BatoSEC25-ECN/girouette/pcb/orders/pcb_test.ods

Component | Vendor | Quantity | Price (unit) | Price (no TVA) | Price (TVA) | Comment | Vendor link
MAX3221EIPWR | Farnell | 4 | 1.37 € | 5.48 € | 6.58 € | NA | https://fr.farnell.com/texas-instruments/max3221eipwr/rs232-transceiver-250kbps-tssop/dp/3006965
LM555CMX/NOPB | Farnell | 4 | 1.23 € | 4.92 € | 5.90 € | NA | https://fr.farnell.com/texas-instruments/lm555cmx-nopb/ic-timer-8soic/dp/3006901
PTV09A-4020F-B104 | Farnell | 8 | 1.00 € | 8.00 € | 9.60 € | NA | https://fr.farnell.com/bourns/ptv09a-4020f-b104/potentiometre-rotatif-100kohm/dp/2469525
LM324AN | Farnell | 4 | 0.82 € | 3.28 € | 3.94 € | NA | https://fr.farnell.com/texas-instruments/lm324an/ic-op-amp-quad-12mhz/dp/3117049
MCUST16A40S12RO | Farnell | 4 | 3.10 € | 12.40 € | 14.88 € | NA | https://fr.farnell.com/multicomp-pro/mcust16a40s12ro/transmitter-40khz-16mm-metal/dp/2362669
MCUSR16A39S12RO | Farnell | 4 | 3.10 € | 12.40 € | 14.88 € | NA | https://fr.farnell.com/multicomp-pro/mcusr16a39s12ro/receiver-39khz-16mm-metal/dp/2362670
XIAO ESP32C3 | Farnell | 4 | 4.75 € | 19.00 € | 22.80 € | Already possessed ? | https://fr.farnell.com/seeed-studio/113991054/carte-developpement-risc-carte/dp/4060379
Resistors |  |  |  |  |  | Already possessed
Capacitors |  |  |  |  |  | Already possessed
Single row 2.54 headers |  |  |  |  |  | Already possessed ?
 |  |  |  | Total price (no TVA) | Total price (TVA)
 |  |  |  | 65.48 € | 93.58 €
 |  |  |  | Delivery and Manipulation fees
 |  |  |  | 15.00 €
