BatoSEC25-ECN/girouette/modeling/pcb_test/3mf/case.3mf

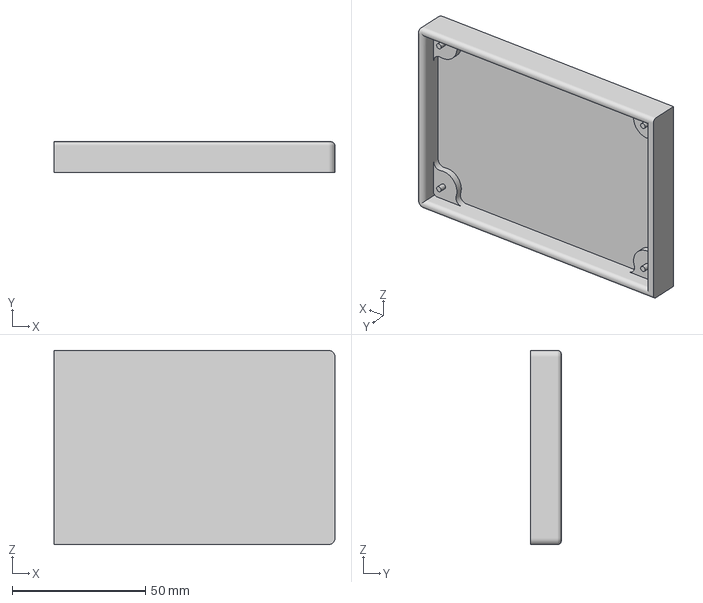
[picture p4: CAD file, 2025-03-26]
modeling/pcb_test/3mf/case.3mf
105.5 x 11.5 x 73.0 mm
