BatoSEC25-ECN/girouette/modeling/pcb_test/3mf/holder_v2/holder_v2_base.3mf

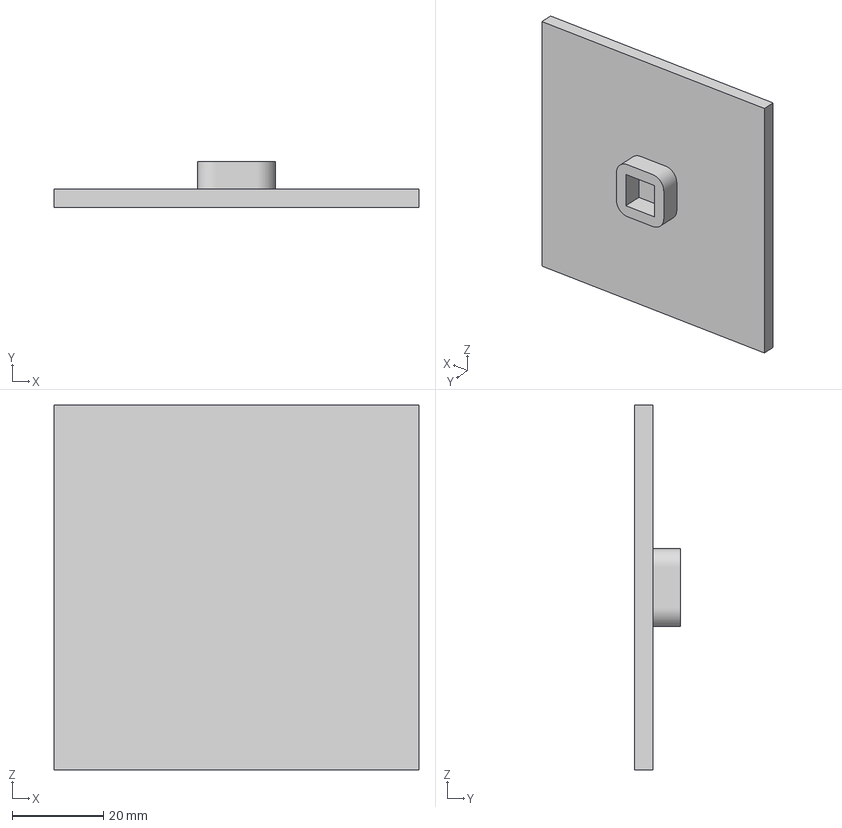
[picture p5: CAD file, 2025-03-26]
modeling/pcb_test/3mf/holder_v2/holder_v2_base.3mf
80.0 x 10.0 x 80.0 mm
