BatoSEC25-ECN/girouette/modeling/pcb_test/3mf/rotating_holder/fix_plate.3mf

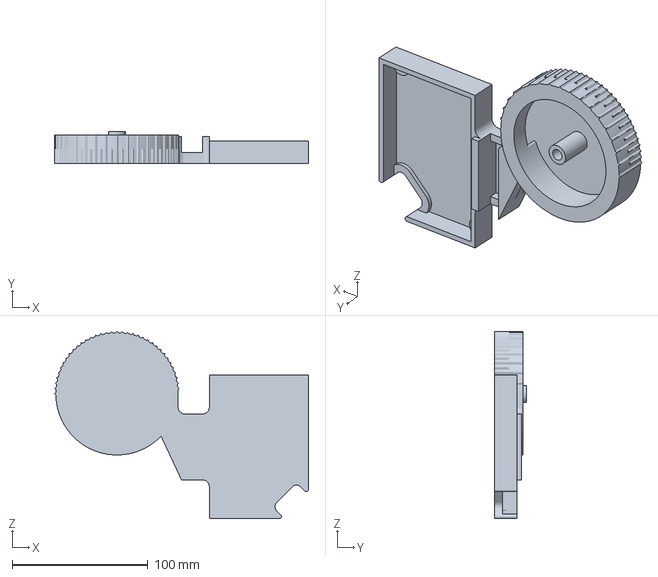
[picture p6: CAD file, 2025-08-08]
modeling/pcb_test/3mf/rotating_holder/fix_plate.3mf
186.9 x 23.5 x 137.7 mm
