BatoSEC25-ECN/girouette/modeling/pcb_test/3mf/holder_v1.3mf

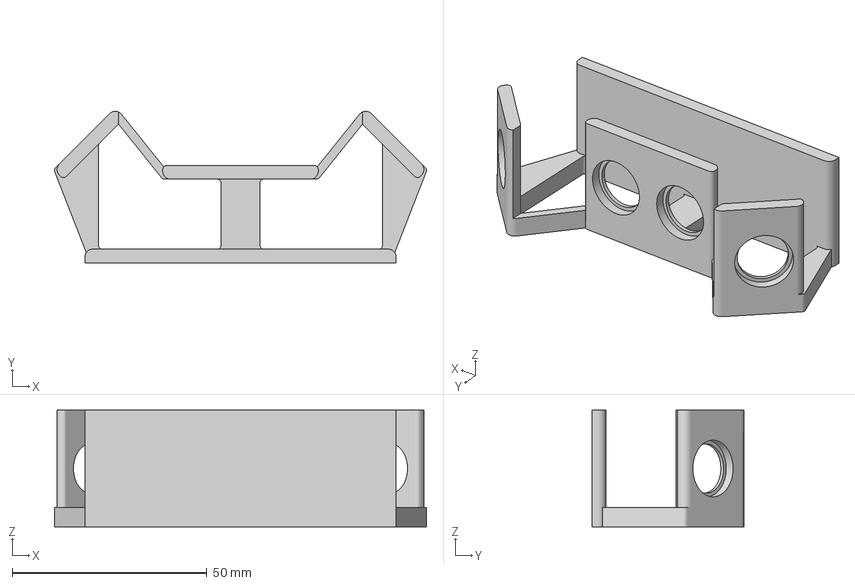
[picture p7: CAD file, 2025-03-26]
modeling/pcb_test/3mf/holder_v1.3mf
95.6 x 39.0 x 30.0 mm
