BatoSEC25-ECN/girouette/modeling/pcb_test/3mf/holder_v2/holder_v2_top_plate.3mf

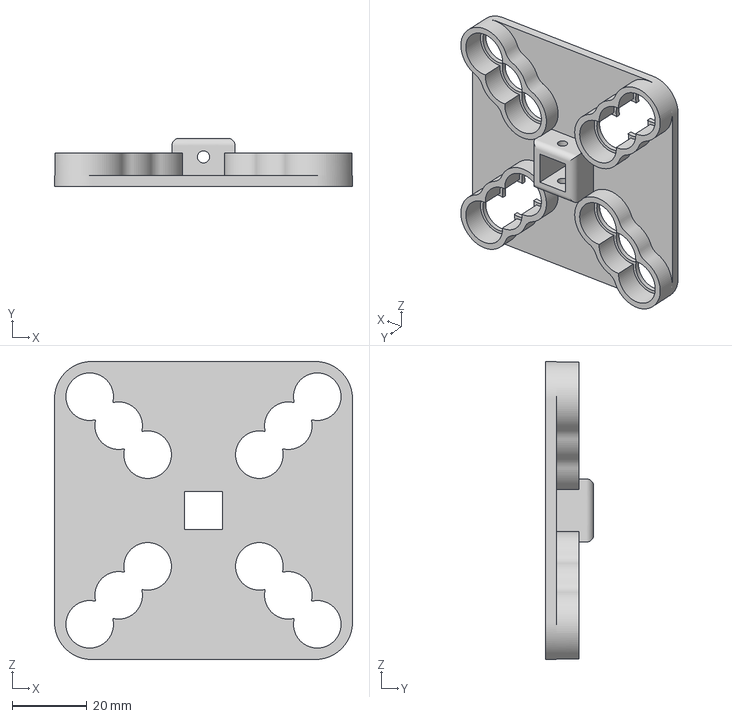
[picture p8: CAD file, 2025-03-26]
modeling/pcb_test/3mf/holder_v2/holder_v2_top_plate.3mf
80.0 x 13.0 x 80.0 mm
