BatoSEC25-ECN/girouette/modeling/pcb_test/3mf/rotating_holder/boucing_tower.3mf

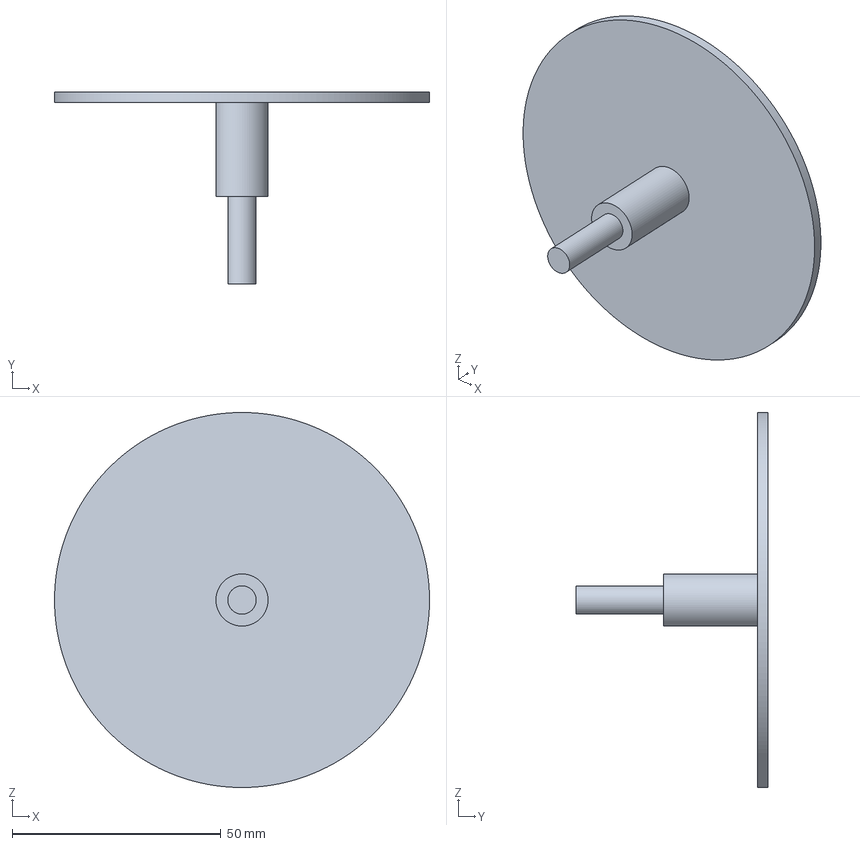
[picture p9: CAD file, 2025-08-08]
modeling/pcb_test/3mf/rotating_holder/boucing_tower.3mf
89.9 x 46.0 x 89.9 mm
