BatoSEC25-ECN/girouette/modeling/pcb_test/3mf/holder_v2/holder_v2_axis.3mf

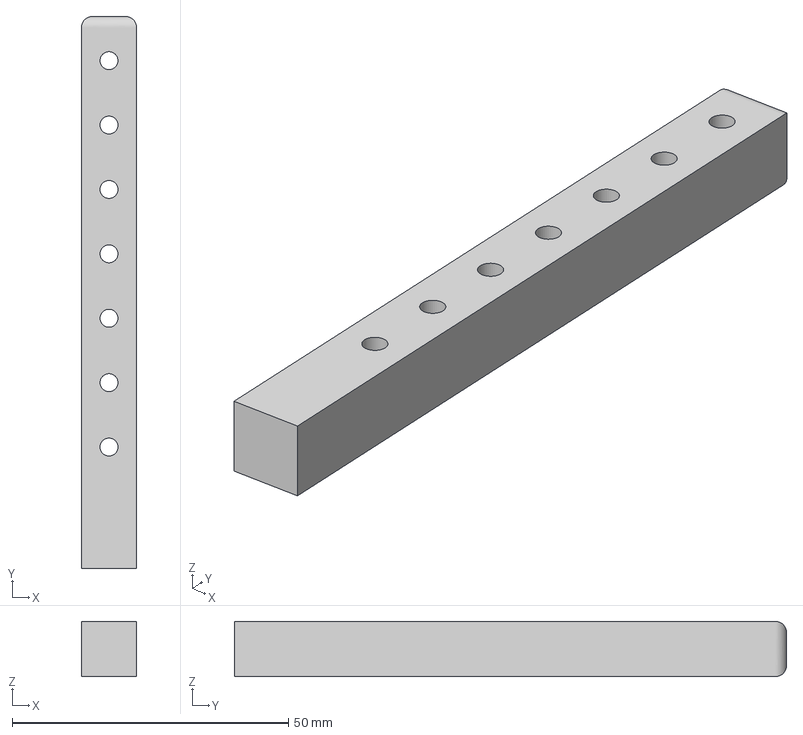
[picture p10: CAD file, 2025-03-26]
modeling/pcb_test/3mf/holder_v2/holder_v2_axis.3mf
10.0 x 100.0 x 10.0 mm
