BatoSEC25-ECN/girouette/modeling/pcb_test/3mf/rotating_holder/rotating_plate.3mf

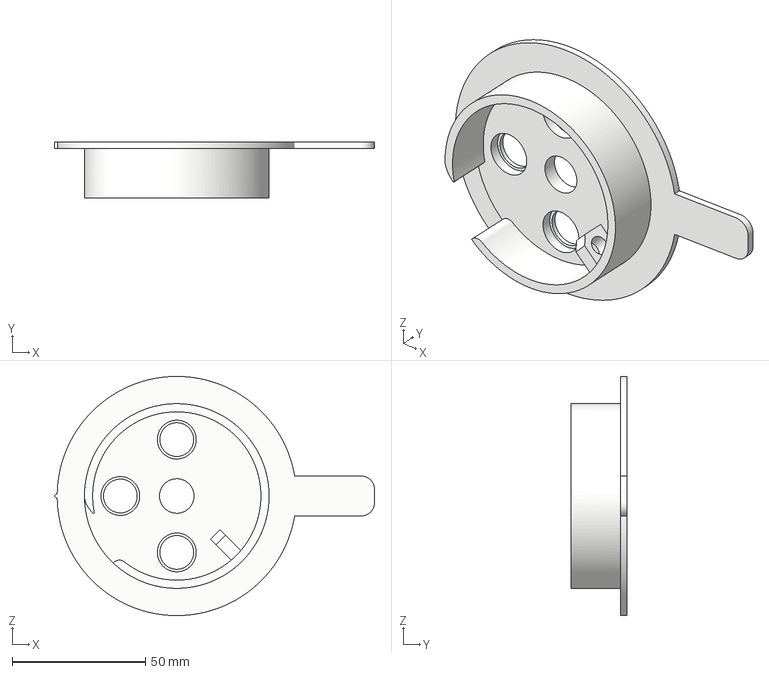
[picture p11: CAD file, 2025-08-08]
modeling/pcb_test/3mf/rotating_holder/rotating_plate.3mf
120.3 x 21.0 x 89.9 mm
