BatoSEC25-ECN/girouette/modeling/pcb_test/3mf/waterproof_sensor.3mf

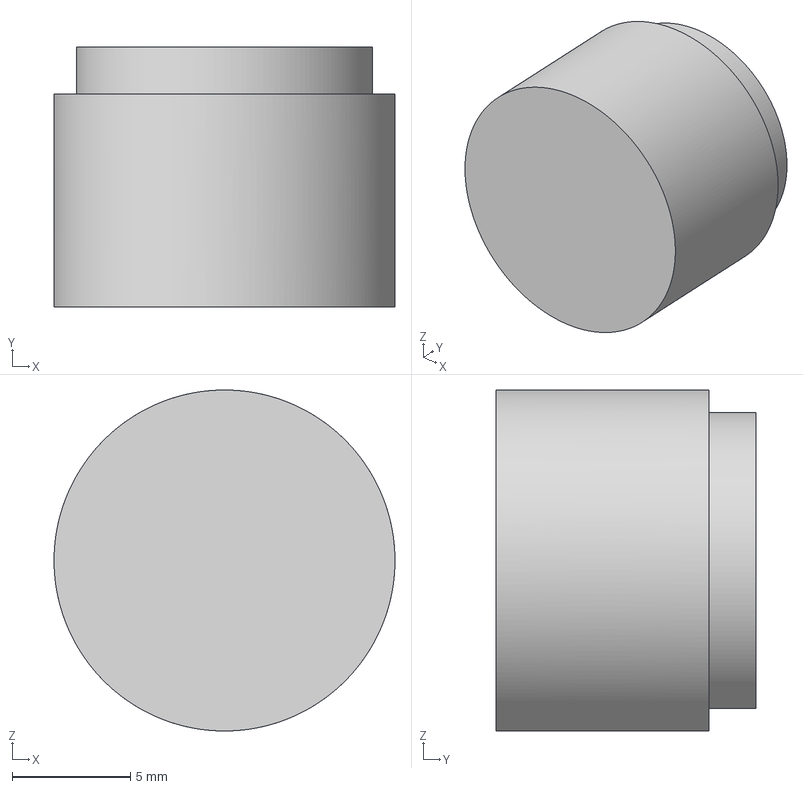
[picture p12: CAD file, 2025-03-26]
modeling/pcb_test/3mf/waterproof_sensor.3mf
14.4 x 11.0 x 14.4 mm
