BatoSEC25-ECN/girouette/(list of files, cad)

Other CAD files:
modeling/pcb_test/fusion360/case.f3z
modeling/pcb_test/fusion360/holder_v1.f3z
modeling/pcb_test/fusion360/holder_v2.f3z
modeling/pcb_test/fusion360/rotating_holder.f3z
modeling/pcb_test/fusion360/waterproof_sensor.f3d
