BatoSEC25-ECN/girouette/pcb/setup.adoc

= Kicad
Kadwalon Lobet, Guillaume de Maricourt.

This project uses Kicad as CAD software. +
To setup this tool, download link:https://www.kicad.org/download/[kicad] here. +
Follow the installation process.

All of the subfolder follow the below folder architecture, ``project_name/project_name.kicad_pro``.

The ``orders`` folder is the only exception. +
This folder is a summary of the orders for teachers which includes :

 - Components
 - Price
 - Quantity
 - Source
