BatoSEC25-ECN/girouette/pcb/pcb_test/pcb_test.kicad_pcb

## KiCad design pcb/pcb_test/pcb_test.kicad_pcb (2025-03-26)

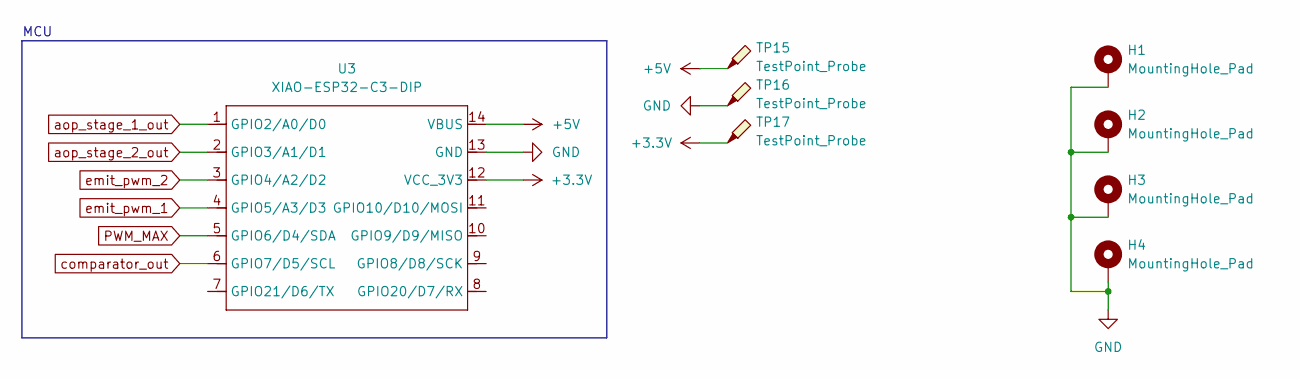
[picture p15: schematic controller.kicad_sch]

Parts:
H1, H2, H3, H4: MountingHole_Pad; MountingHole_2.2mm_M2_Pad_TopBottom
TP15, TP16, TP17: TestPoint_Probe; TestPoint_THTPad_3.0x3.0mm_Drill1.5mm
U3: XIAO-ESP32-C3-DIP; XIAO-ESP32C3-DIP

Connections:
+3.3V: TP17.1, U3.12 (VCC_3V3); also elsewhere on the board
+5V: TP15.1, U3.14 (VBUS); also elsewhere on the board
GND: H1.1, H2.1, H3.1, H4.1, TP16.1, U3.13 (GND); also elsewhere on the board
PWM_MAX: U3.5 (GPIO6/D4/SDA); also elsewhere on the board
aop_stage_1_out: U3.1 (GPIO2/A0/D0); also elsewhere on the board
aop_stage_2_out: U3.2 (GPIO3/A1/D1); also elsewhere on the board
comparator_out: U3.6 (GPIO7/D5/SCL); also elsewhere on the board
emit_pwm_1: U3.4 (GPIO5/A3/D3); also elsewhere on the board
emit_pwm_2: U3.3 (GPIO4/A2/D2); also elsewhere on the board

Notes on the sheet:
MCU

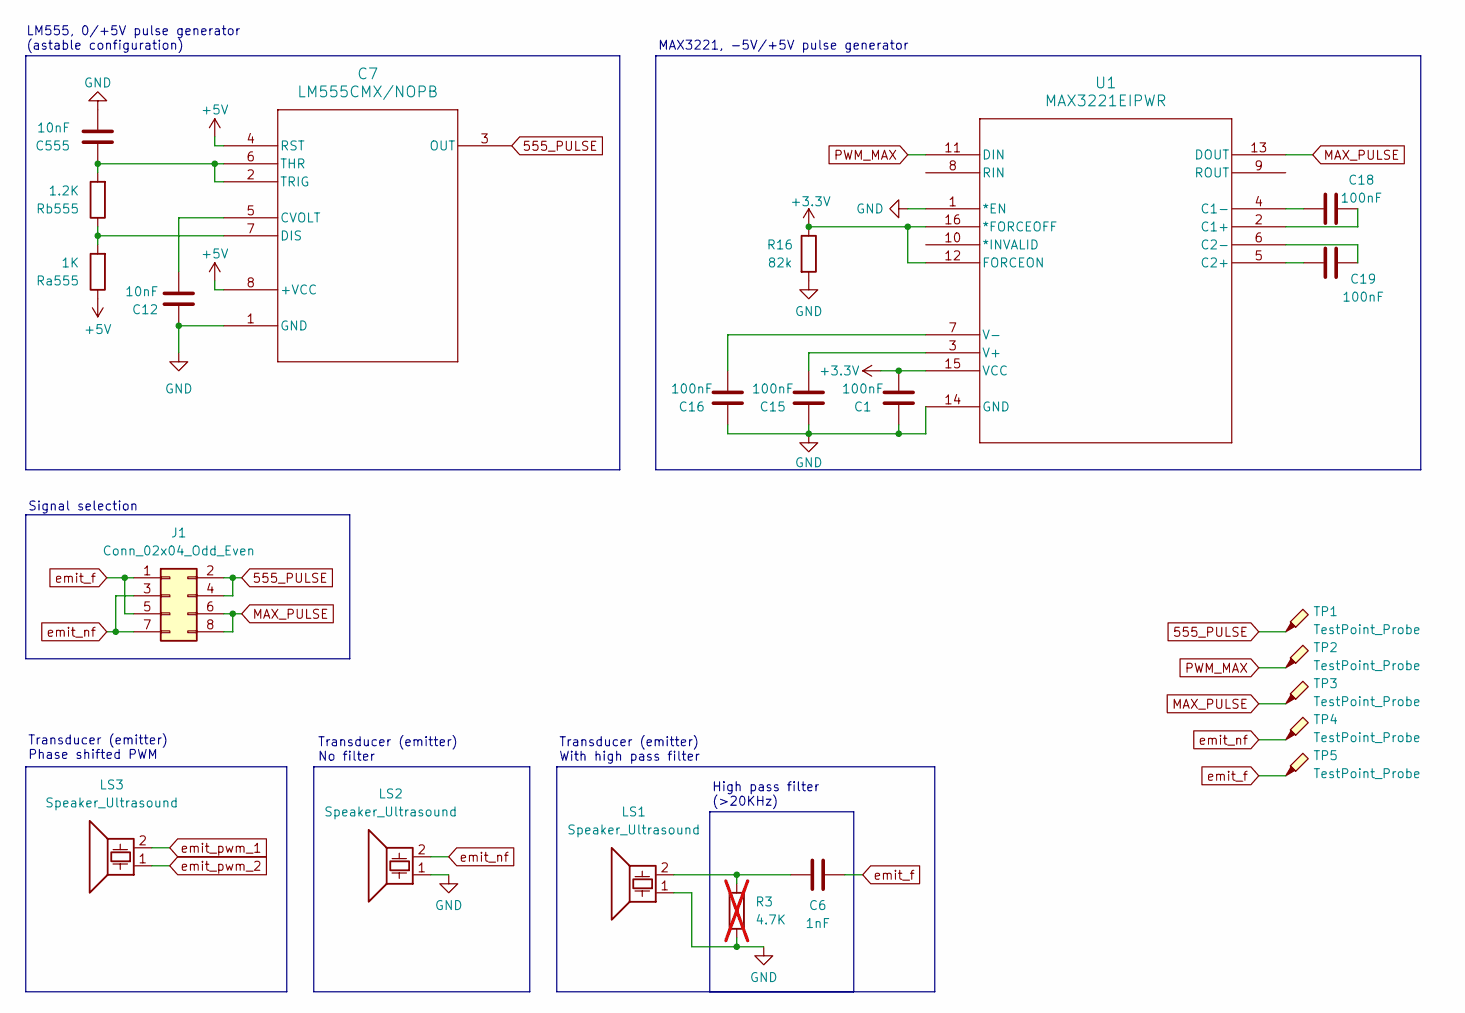
[picture p16: schematic transceiver_output.kicad_sch]

Parts:
C1, C15, C16, C18, C19: 100nF; C_Disc_D4.3mm_W1.9mm_P5.00mm
C6: 1nF; C_Disc_D4.3mm_W1.9mm_P5.00mm
C7: LM555CMX/NOPB; M08A-M
C12: 10nF; C_Disc_D4.3mm_W1.9mm_P5.00mm
C555: 10nF
J1: Conn_02x04_Odd_Even; PinHeader_2x04_P2.54mm_Vertical
LS1, LS2, LS3: Speaker_Ultrasound; PinHeader_1x02_P2.54mm_Vertical
R3: 4.7K; R_Axial_DIN0207_L6.3mm_D2.5mm_P10.16mm_Horizontal; not fitted
R16: 82k; R_Axial_DIN0207_L6.3mm_D2.5mm_P10.16mm_Horizontal
Ra555: 1K; R_Axial_DIN0207_L6.3mm_D2.5mm_P10.16mm_Horizontal
Rb555: 1.2K; R_Axial_DIN0207_L6.3mm_D2.5mm_P10.16mm_Horizontal
TP1, TP2, TP3, TP4, TP5: TestPoint_Probe; TestPoint_THTPad_3.0x3.0mm_Drill1.5mm
U1: MAX3221EIPWR; PW16-M

Connections:
555_PULSE: C7.3 (OUT), J1.2, J1.4, TP1.1
+3.3V: C1.2, R16.1, U1.12 (FORCEON), U1.15 (VCC), U1.16 (*FORCEOFF); also elsewhere on the board
+5V: C7.4 (RST), C7.8 (+VCC), Ra555.1; also elsewhere on the board
GND: C1.1, C7.1 (GND), C12.1, C15.1, C16.1, C555.2, LS1.1, LS2.1, R3.2, R16.2, U1.1 (*EN), U1.14 (GND); also elsewhere on the board
MAX_PULSE: J1.6, J1.8, TP3.1, U1.13 (DOUT)
unnamed: C6.1, LS1.2, R3.1
unnamed: C7.5 (CVOLT), C12.2
unnamed: C7.7 (DIS), Ra555.2, Rb555.1
unnamed 8: C7.2 (TRIG), C7.6 (THR), C555.1, Rb555.2; also elsewhere on the board
unnamed: C18.2, U1.2 (C1+)
unnamed: C18.1, U1.4 (C1-)
unnamed: C19.1, U1.5 (C2+)
unnamed: C19.2, U1.6 (C2-)
unnamed: C15.2, U1.3 (V+)
unnamed: C16.2, U1.7 (V-)
PWM_MAX: TP2.1, U1.11 (DIN); also elsewhere on the board
emit_f: C6.2, J1.1, J1.5, TP5.1
emit_nf: J1.3, J1.7, LS2.2, TP4.1
emit_pwm_1: LS3.2; also elsewhere on the board
emit_pwm_2: LS3.1; also elsewhere on the board

Notes on the sheet:
Transducer (emitter) No filter
Signal selection
LM555, 0/+5V pulse generator (astable configuration)
MAX3221, -5V/+5V pulse generator
High pass filter (>20KHz)
Transducer (emitter) Phase shifted PWM
Transducer (emitter) With high pass filter

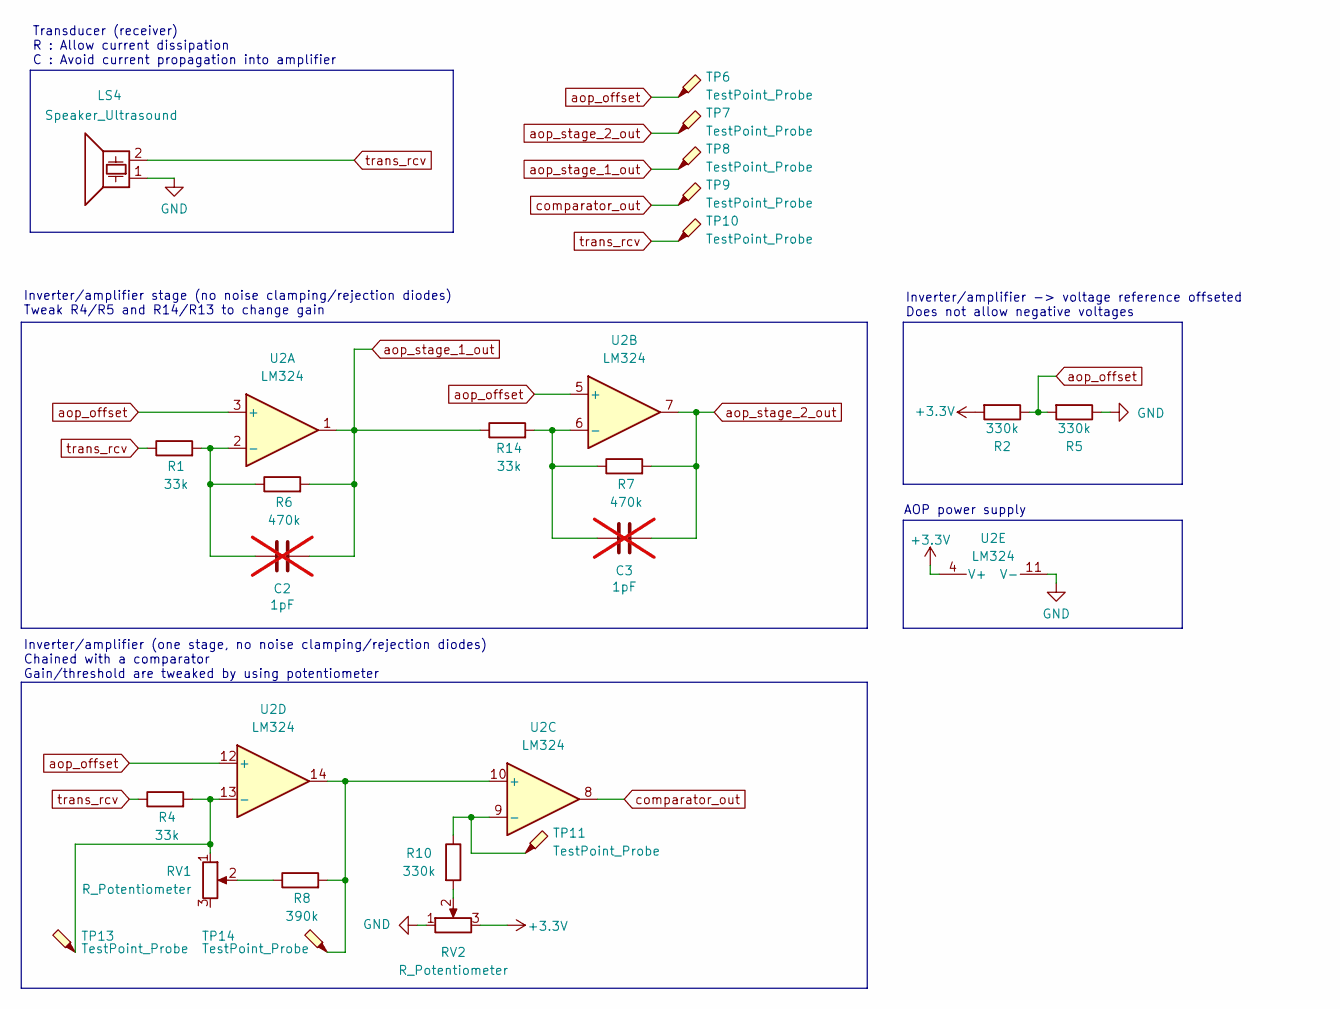
[picture p17: schematic transceiver_input.kicad_sch]

Parts:
C2, C3: 1pF; C_Disc_D4.3mm_W1.9mm_P5.00mm; not fitted
LS4: Speaker_Ultrasound; PinHeader_1x02_P2.54mm_Vertical
R1, R4, R14: 33k; R_Axial_DIN0207_L6.3mm_D2.5mm_P10.16mm_Horizontal
R2, R5, R10: 330k; R_Axial_DIN0207_L6.3mm_D2.5mm_P10.16mm_Horizontal
R6, R7: 470k; R_Axial_DIN0207_L6.3mm_D2.5mm_P10.16mm_Horizontal
R8: 390k; R_Axial_DIN0207_L6.3mm_D2.5mm_P10.16mm_Horizontal
RV1, RV2: R_Potentiometer; Potentiometer_Bourns_PTV09A-1_Single_Vertical
TP6, TP7, TP8, TP9, TP10, TP11, TP13, TP14: TestPoint_Probe; TestPoint_THTPad_3.0x3.0mm_Drill1.5mm
U2: LM324; N14

Connections:
+3.3V: R2.2, RV2.3, U2.4 (V+); also elsewhere on the board
GND: LS4.1, R5.1, RV2.1, U2.11 (V-); also elsewhere on the board
unnamed: R8.1, RV1.2
unnamed: R10.2, RV2.2
unnamed: C2.2, R1.2, R6.1, U2.2 (-)
unnamed: C3.2, R7.1, R14.2, U2.6 (-)
unnamed: R8.2, TP14.1, U2.10 (+), U2.14
unnamed: R10.1, TP11.1, U2.9 (-)
unnamed: R4.2, RV1.1, TP13.1, U2.13 (-)
aop_offset: R2.1, R5.2, TP6.1, U2.3 (+), U2.5 (+), U2.12 (+)
aop_stage_1_out: C2.1, R6.2, R14.1, TP8.1, U2.1; also elsewhere on the board
aop_stage_2_out: C3.1, R7.2, TP7.1, U2.7; also elsewhere on the board
comparator_out: TP9.1, U2.8; also elsewhere on the board
trans_rcv: LS4.2, R1.1, R4.1, TP10.1

Notes on the sheet:
Inverter/amplifier -> voltage reference offseted Does not allow negative voltages
Inverter/amplifier (one stage, no noise clamping/rejection diodes) Chained with a comparator Gain/threshold are tweaked by using potentiometer
AOP power supply
Inverter/amplifier stage (no noise clamping/rejection diodes) Tweak R4/R5 and R14/R13 to change gain
Transducer (receiver) R : Allow current dissipation C : Avoid current propagation into amplifier

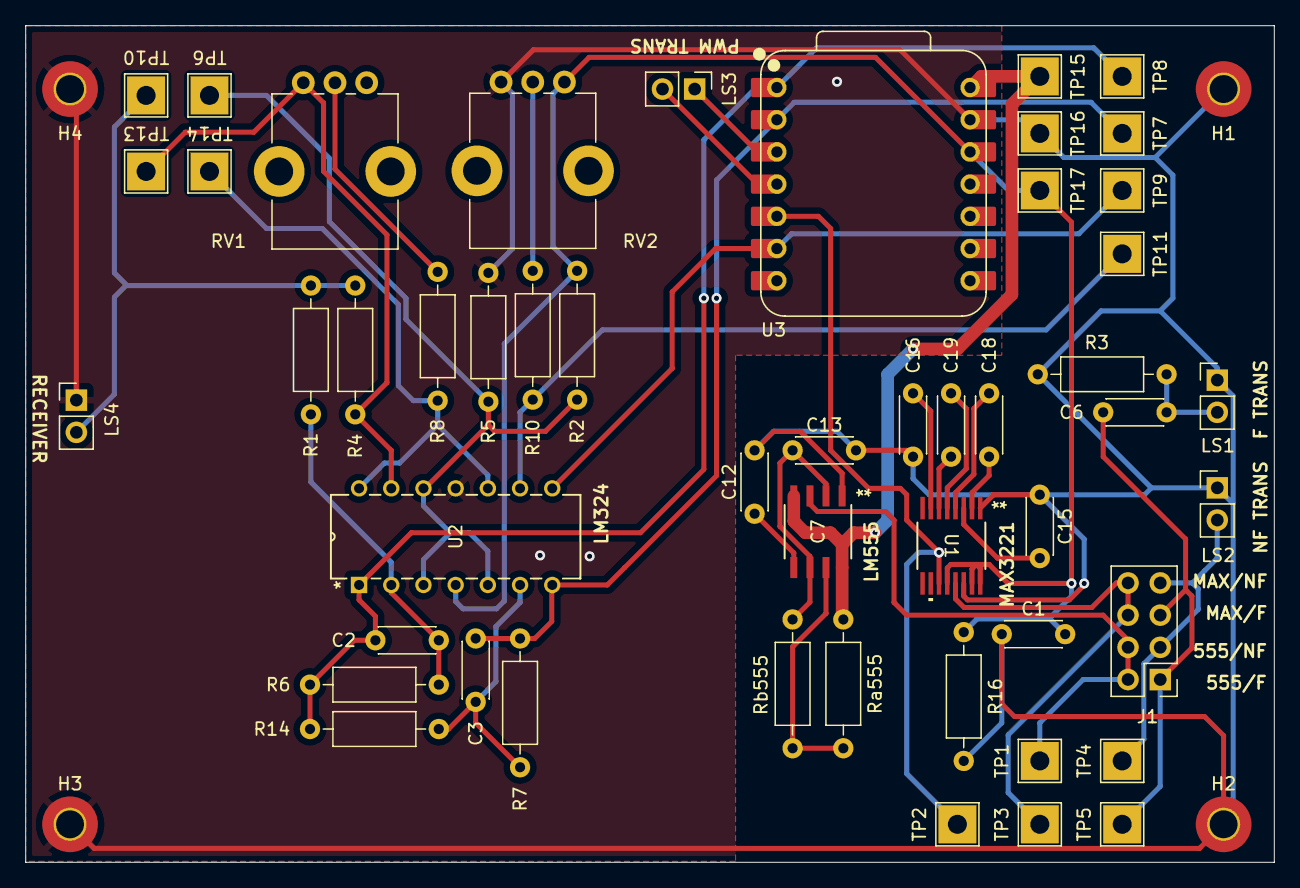
[picture p18: board pcb_test.kicad_pcb from above]

Board: 2 copper layers, 98.5 x 66.0 mm, 54 parts (0 on the bottom side), 32 nets.

Other parts of the board:
C13: 10nF; C_Disc_D4.3mm_W1.9mm_P5.00mm

Their connections:
GND: C13.2; also elsewhere on the board
unnamed 8: C13.1; also elsewhere on the board
