BatoSEC25-ECN/girouette/(commit log)

2025-03-26 Pcb test (#4)
    * chore(gitignore): update gitignore
    * feat(pcb_v0): Create first pcb version (v0, for test purpose)"
    * chore(prod_files): add production generated files
    * chore: Add BOM file
    * fix(pcb): update design to match teacher requirements
    * fix(pcb): update footprints to solve ERC issues
    * chore(order): update order list
    * doc: add components datasheet
    * fix(pcb_v0): Update resistor and capacitor values
    * fix: Update gitignore for kicad and openoffice
    * fix: clean project
    - Remove duplicated components datasheet
    - Remove duplicated production files (old version, never ordered)
    * feat!(3D): Add 3D printer (3mf) and Fusion 360 (f3z) files.
    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
    [BOM.csv, analog_circuit.kicad_sch, case.3mf, case.f3z, controller.kicad_sch, holder_v1.3mf, holder_v1.f3z, holder_v2.f3z]
2025-05-19 feat!: create MCU pwm burst generation
2025-05-19 feat!: add possibility of running multiple tests
    Add multiple features to run "infinite" amount of tests:
    - plotter handles an undefined amount of .csv files from a list (restr
    icted to 5 colors though, curves color could overlap)
    - keysight file formatting is standardized (lower case, ensure .csv at
    the end, replace spaces with underscore)
    - main is updated to run an undefined amount of measurement, prompting
    the user to run the next test
    [keysight.py, main.py, plotter.py]
2025-05-24 fix:clean probe ratio
    D:\Documents\41_Ecole\4_Centrale_Nantes\A3\_Projet_bateau\girouette\code\measure_tool\main.py
    [dataclass.py, main.py]
2025-05-25 feat: reimplement probe ratio
    D:\Documents\41_Ecole\4_Centrale_Nantes\A3\_Projet_bateau\girouette\code\measure_tool\dataclass.pyD:\Documents\41_Ecole\4_Centrale_Nantes\A3\_Projet_bateau\girouette\code\measure_tool\keysight.py
2025-06-25 fix: fix plotter issues
    D:\Documents\41_Ecole\4_Centrale_Nantes\A3\_Projet_bateau\girouette\code\measure_tool\plotter.py
    [main.py, plotter.py]
2025-06-25 fix: patch frequency clamping
    [dataclass.py, keysight.py]
2025-08-08 feat: add fusion360 rotating test bench
    [boucing_tower.3mf, fix_plate.3mf, rotating_holder.f3z, rotating_plate.3mf]
